Mathieu-Raffaghello/Boite-s-quentielle/README.md

# Selecteur-de-boite-sequentielle
Système de robotisation pour transformer la commande d'une boite de vitesse traditionnelle en H en commande séquentielle en gardant la boite d'origine
