Mathieu-Raffaghello/Boite-s-quentielle/Documentation/Diagramme de Gantt.pdf

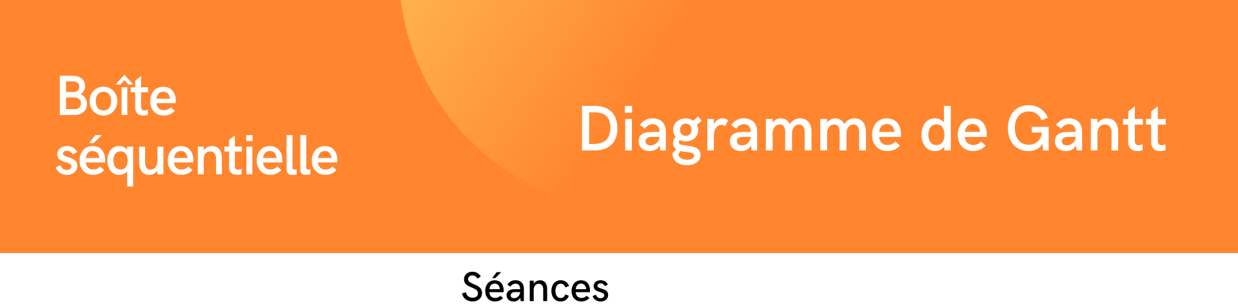
[picture p32: figure]
Boîte; séquentielle; Diagramme de Gantt; Séances

Tâches | 1

Algorithme

Code

Modelisation 3D Poignée (?)

Croquis

Gestion afficheur

Maquette (?)

Montage final

Découpes

2 | 3 | 4 | 5 | 6 | 7 | 8
