Mathieu-Raffaghello/Boite-s-quentielle/code/Algorigramme_Code.pdf

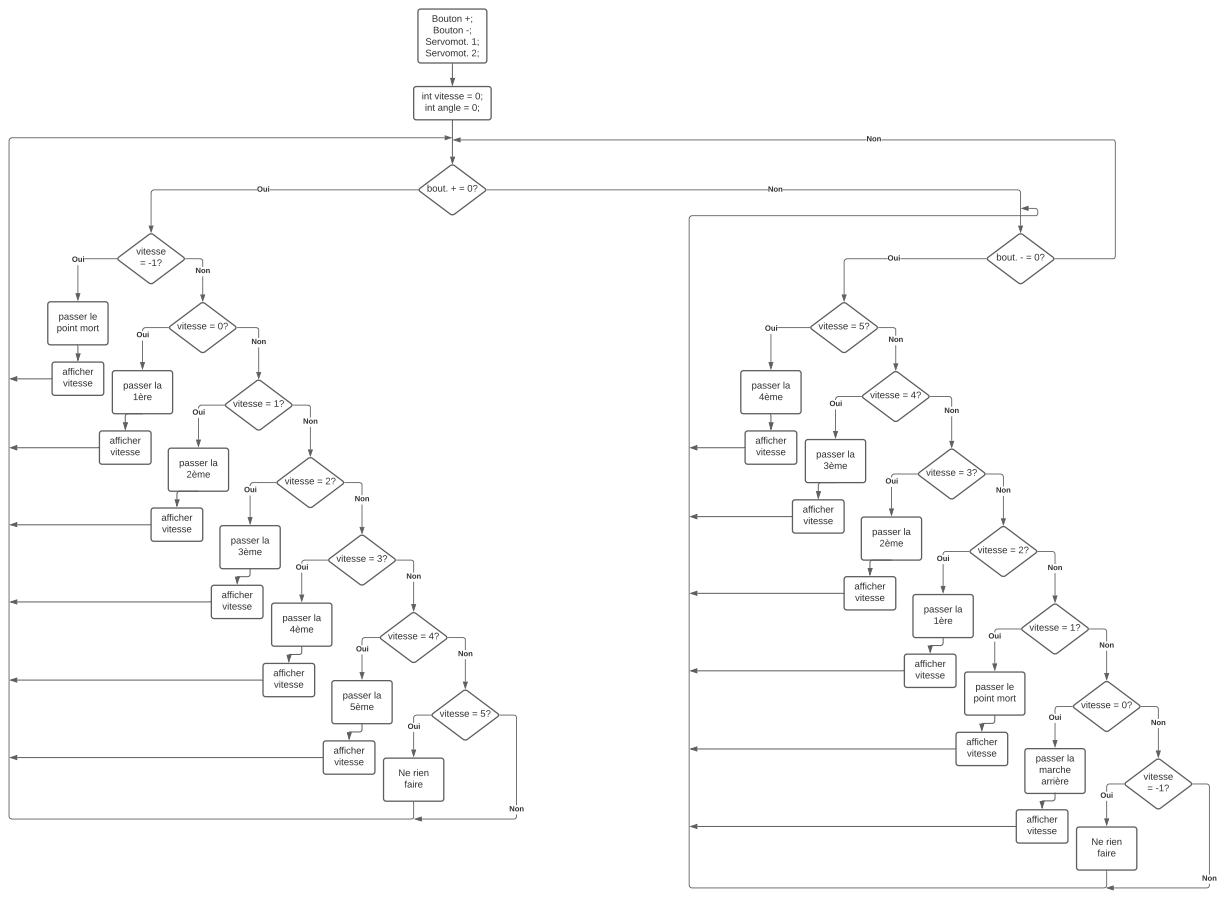
[picture p33: page 1]
Bouton +; Bouton -; Servomot. 1; Servomot. 2;; int vitesse = 0; int angle = 0;; Oui; bout. + = 0?; vitesse = -1? Oui; passer le point mort; Non; vitesse = 0?; passer la 1ère; vitesse = 1?; passer la 2ème; vitesse = 2?; passer la 3ème; vitesse = 3?; passer la 4ème; vitesse = 4?; passer la 5ème; afficher vitesse; vitesse = 5?; Ne rien faire; passer la marche arrière; vitesse = -1?; bout. - = 0?
