Mathieu-Raffaghello/Boite-s-quentielle/(commit log)

2021-12-03 Create Exemple_Servo.ino
    Exemple d'utilisation de la bibliothèque Servo
2021-12-03 Add files via upload
    Algorigramme décrivant ce que doit faire le code
2021-12-03 Add files via upload
    Rapport de la première séance
